harryxni/TopMetalSe-OpenMPW6/Photos/m5_small.jpg

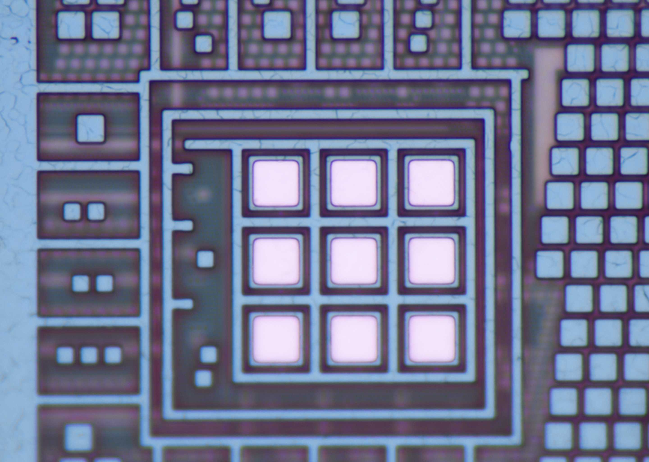
Photos/m5_small.jpg
