harryxni/TopMetalSe-OpenMPW6/Photos/tmse11.jpg

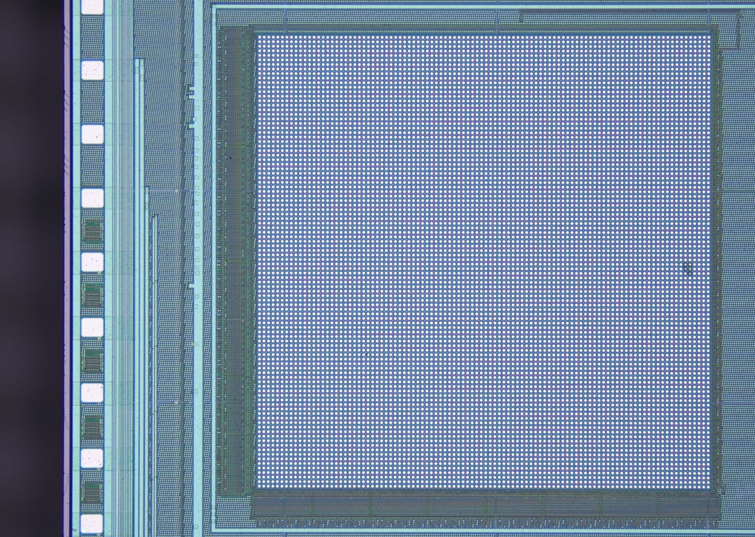
Photos/tmse11.jpg
