harryxni/TopMetalSe-OpenMPW6/Photos/tmse14.jpg

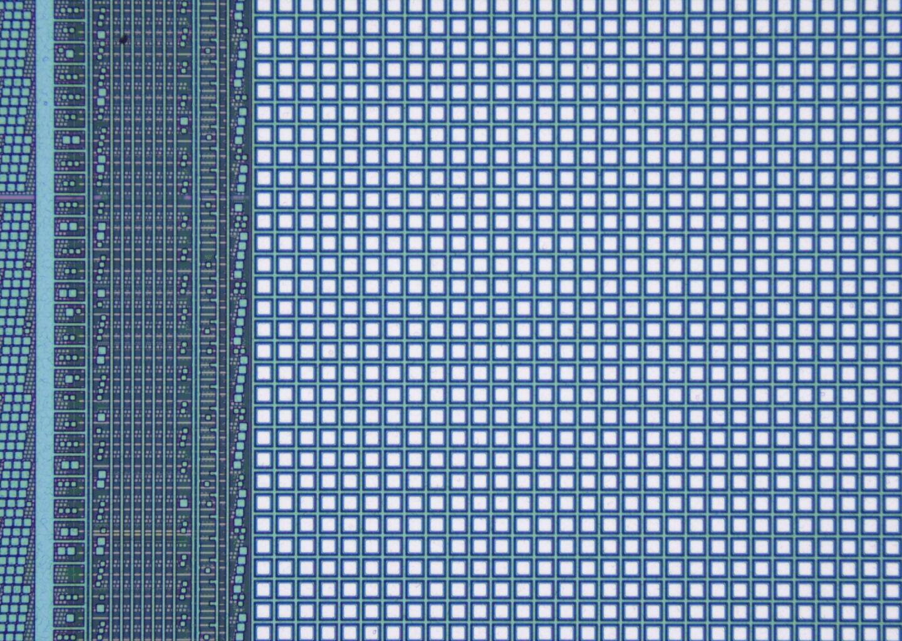
Photos/tmse14.jpg
