harryxni/TopMetalSe-OpenMPW6/Photos/tmse16.jpg

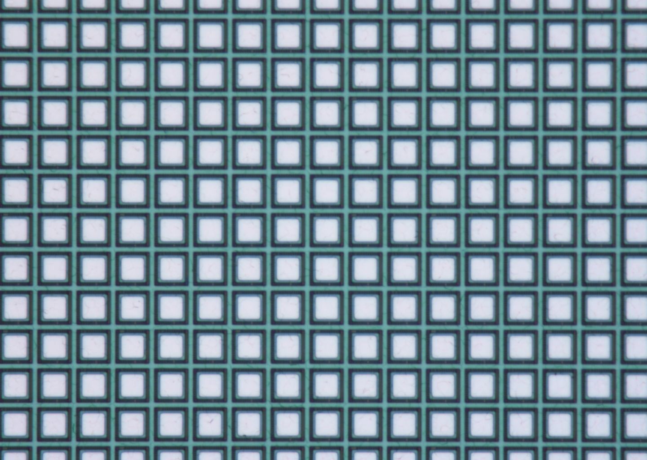
Photos/tmse16.jpg
