harryxni/TopMetalSe-OpenMPW6/Photos/tmse17.jpg

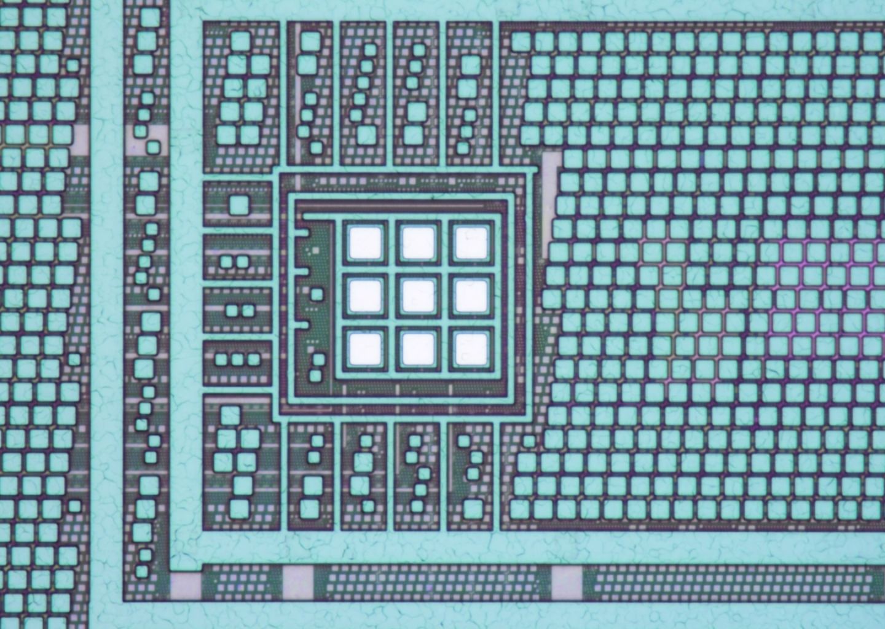
Photos/tmse17.jpg
