harryxni/TopMetalSe-OpenMPW6/Photos/tmse19.jpg

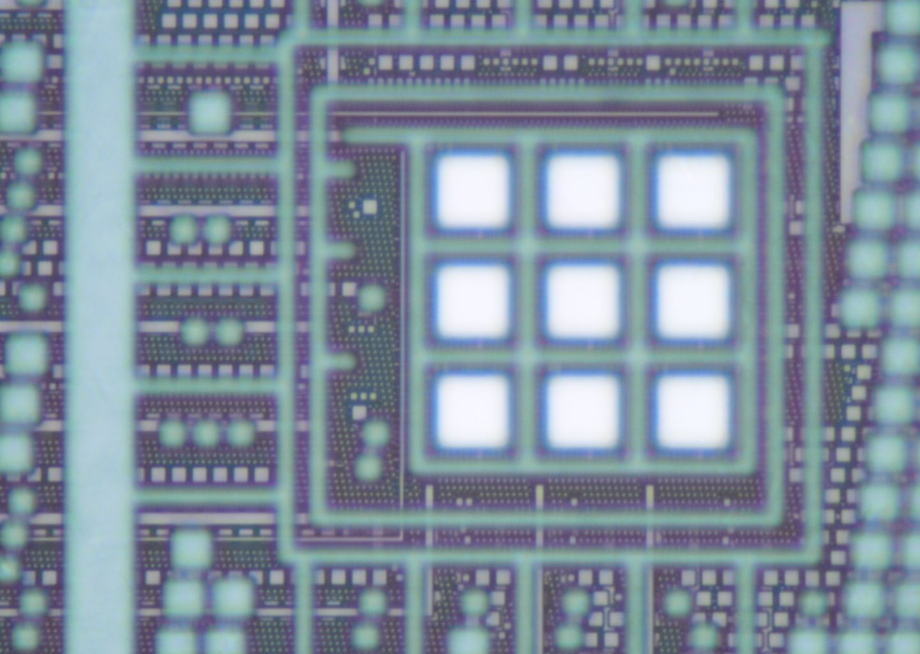
Photos/tmse19.jpg
