harryxni/TopMetalSe-OpenMPW6/Photos/tmse-dps00.jpg

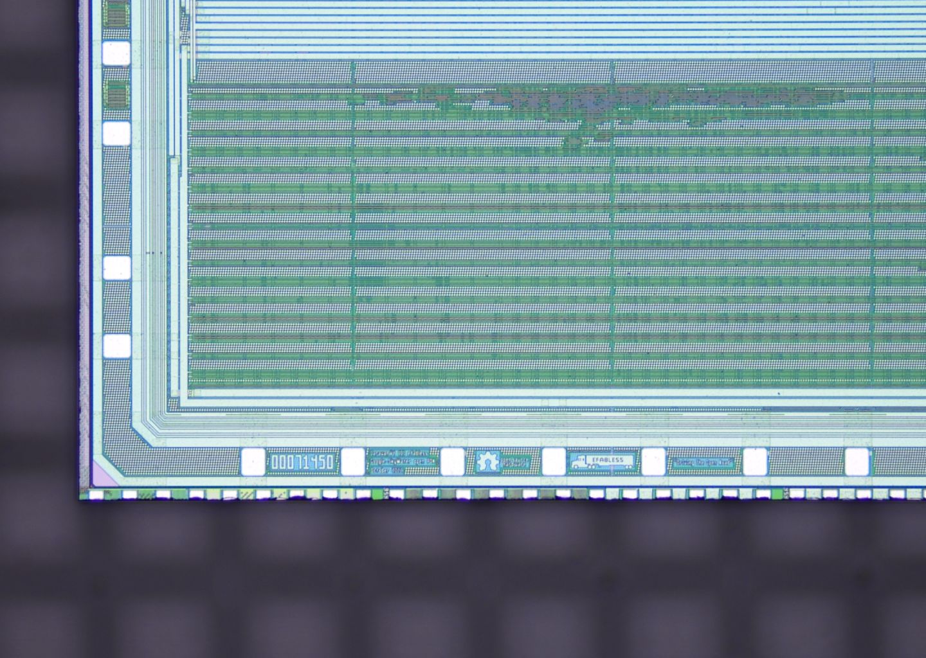
Photos/tmse-dps00.jpg
