harryxni/TopMetalSe-OpenMPW6/Photos/tmse-dps01.jpg

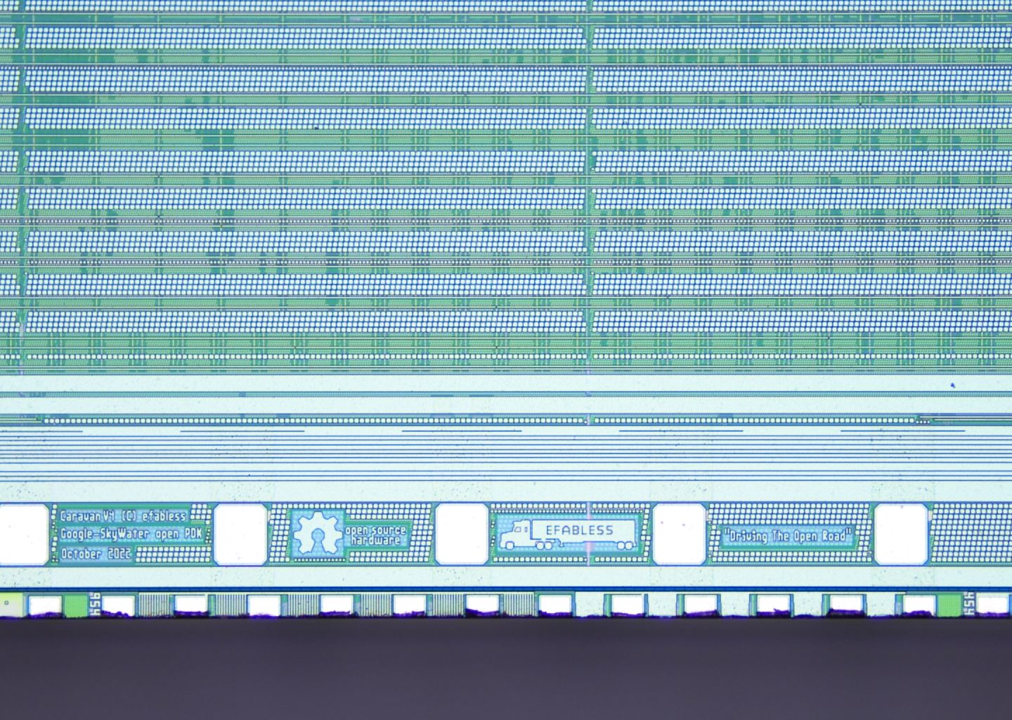
Photos/tmse-dps01.jpg
