harryxni/TopMetalSe-OpenMPW6/Photos/tmse-dps02.jpg

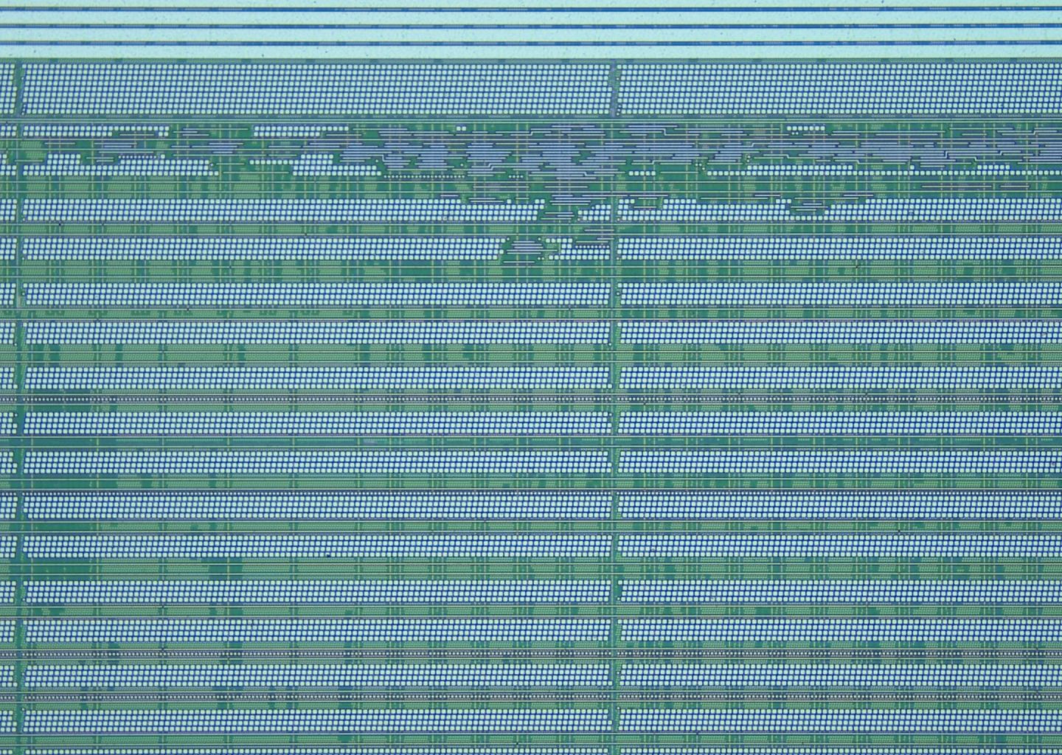
Photos/tmse-dps02.jpg
