harryxni/TopMetalSe-OpenMPW6/Photos/tmse-dps06.jpg

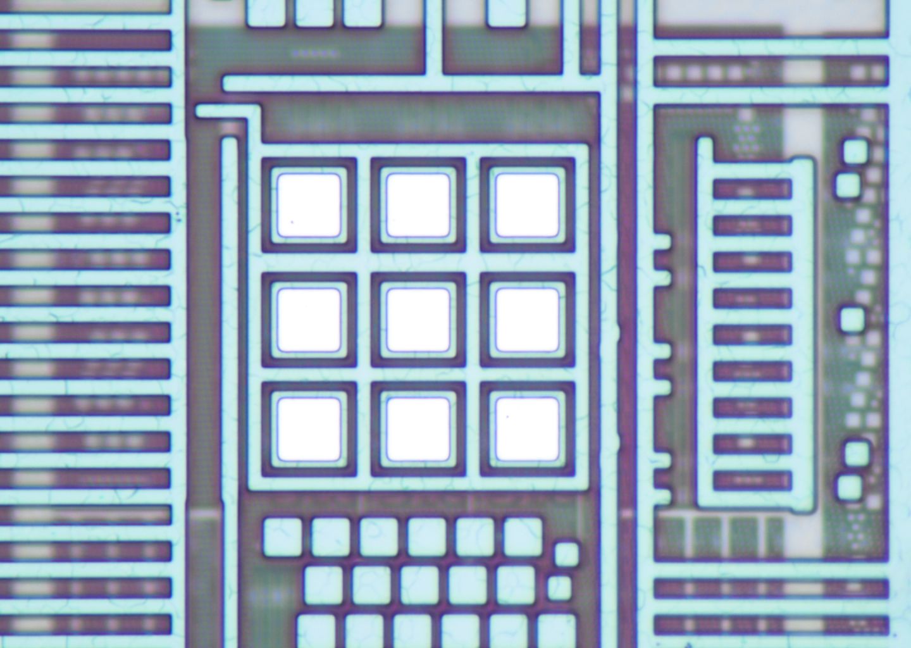
Photos/tmse-dps06.jpg
