harryxni/TopMetalSe-OpenMPW6/Photos/tmse-dps08.jpg

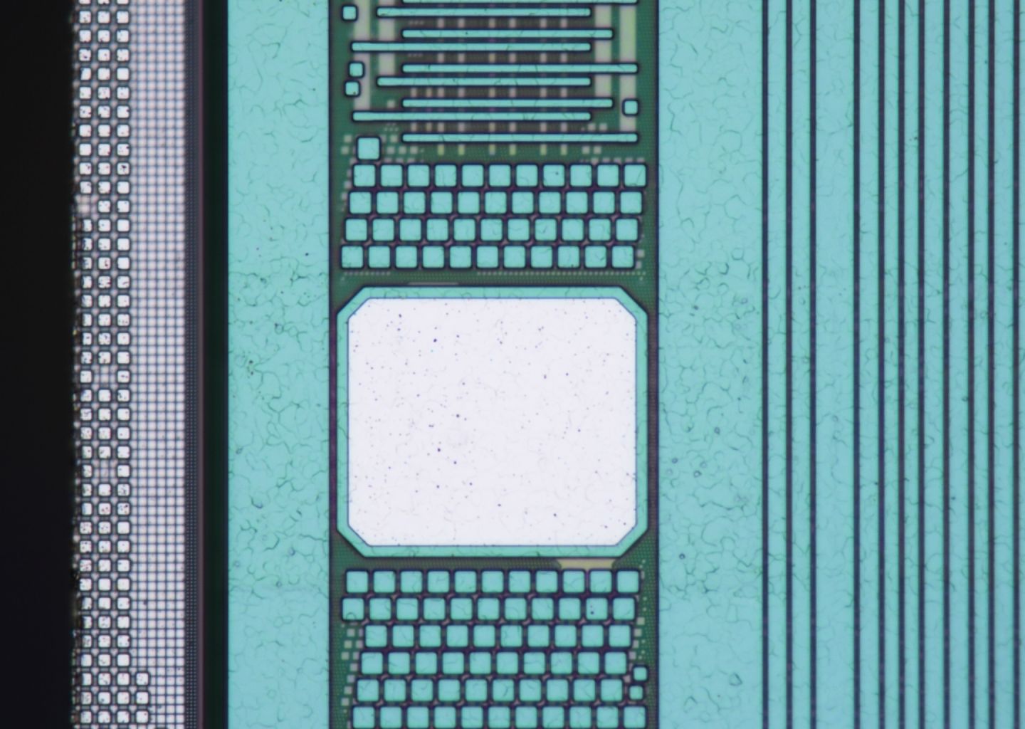
Photos/tmse-dps08.jpg
