harryxni/TopMetalSe-OpenMPW6/Photos/tmse-dps09.jpg

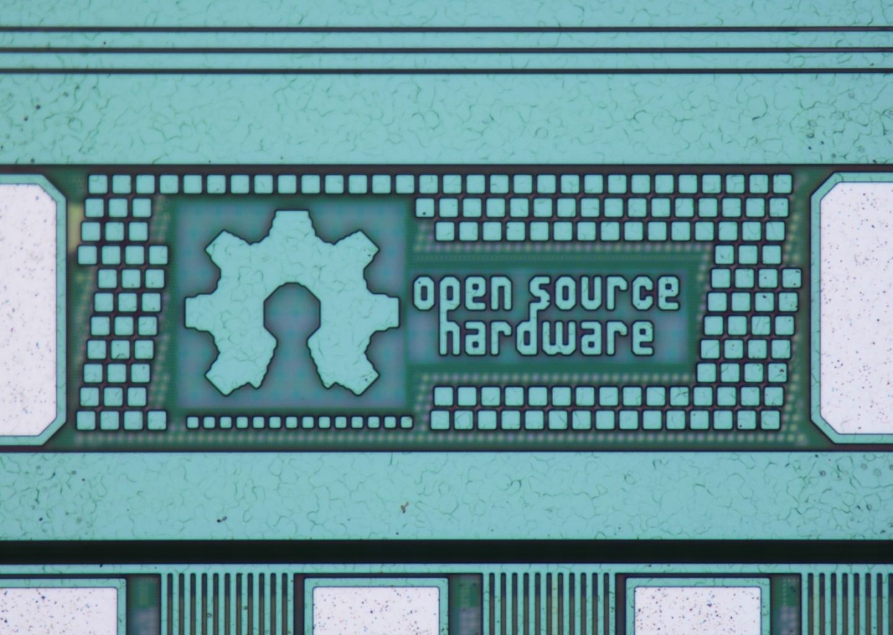
Photos/tmse-dps09.jpg
