harryxni/TopMetalSe-OpenMPW6/Photos/tmse-dps10.jpg

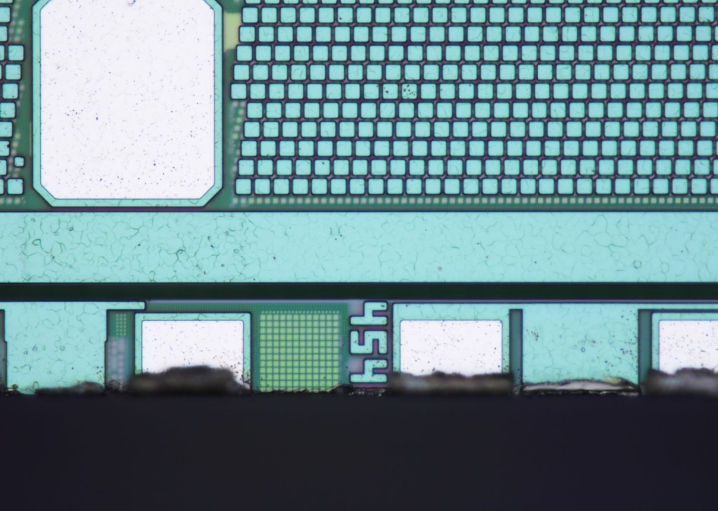
Photos/tmse-dps10.jpg
