harryxni/TopMetalSe-OpenMPW6/xschem/csa.pdf

# /home/damic/CMOS/TopmetalSe/Pixel/Schematic/csa.sch

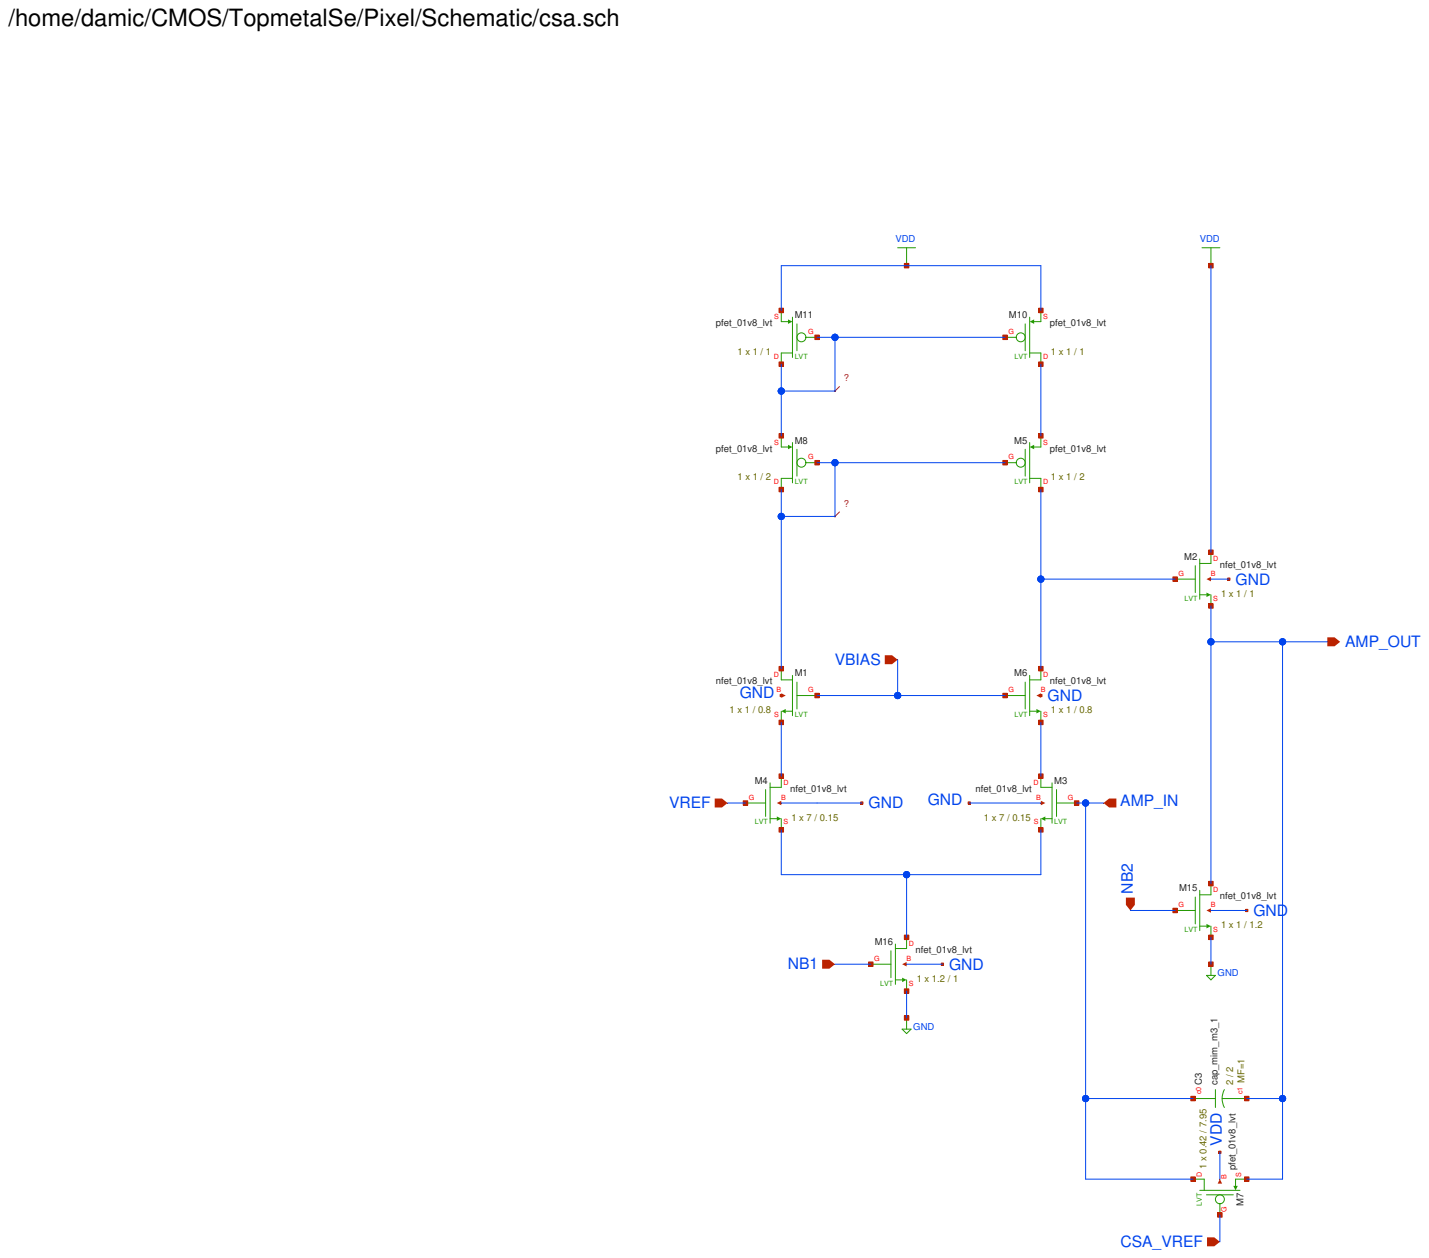
[picture p23: page 1]
VDD; GND; VREF; AMP_IN; CSA_VREF; VBIAS; AMP_OUT; nfet_01v8_lvt; 1 x 1 / 1 LVT; LVT; pfet_01v8_lvt; 1 x 1 / 1.2 LVT; 1 x 1.2 / 1 LVT; cap_mim_m3_1; 1 x 7 / 0.15 LVT; 1 x 1 / 0.8 LVT
