harryxni/TopMetalSe-OpenMPW6/xschem/pixel.pdf

# untitled.sch

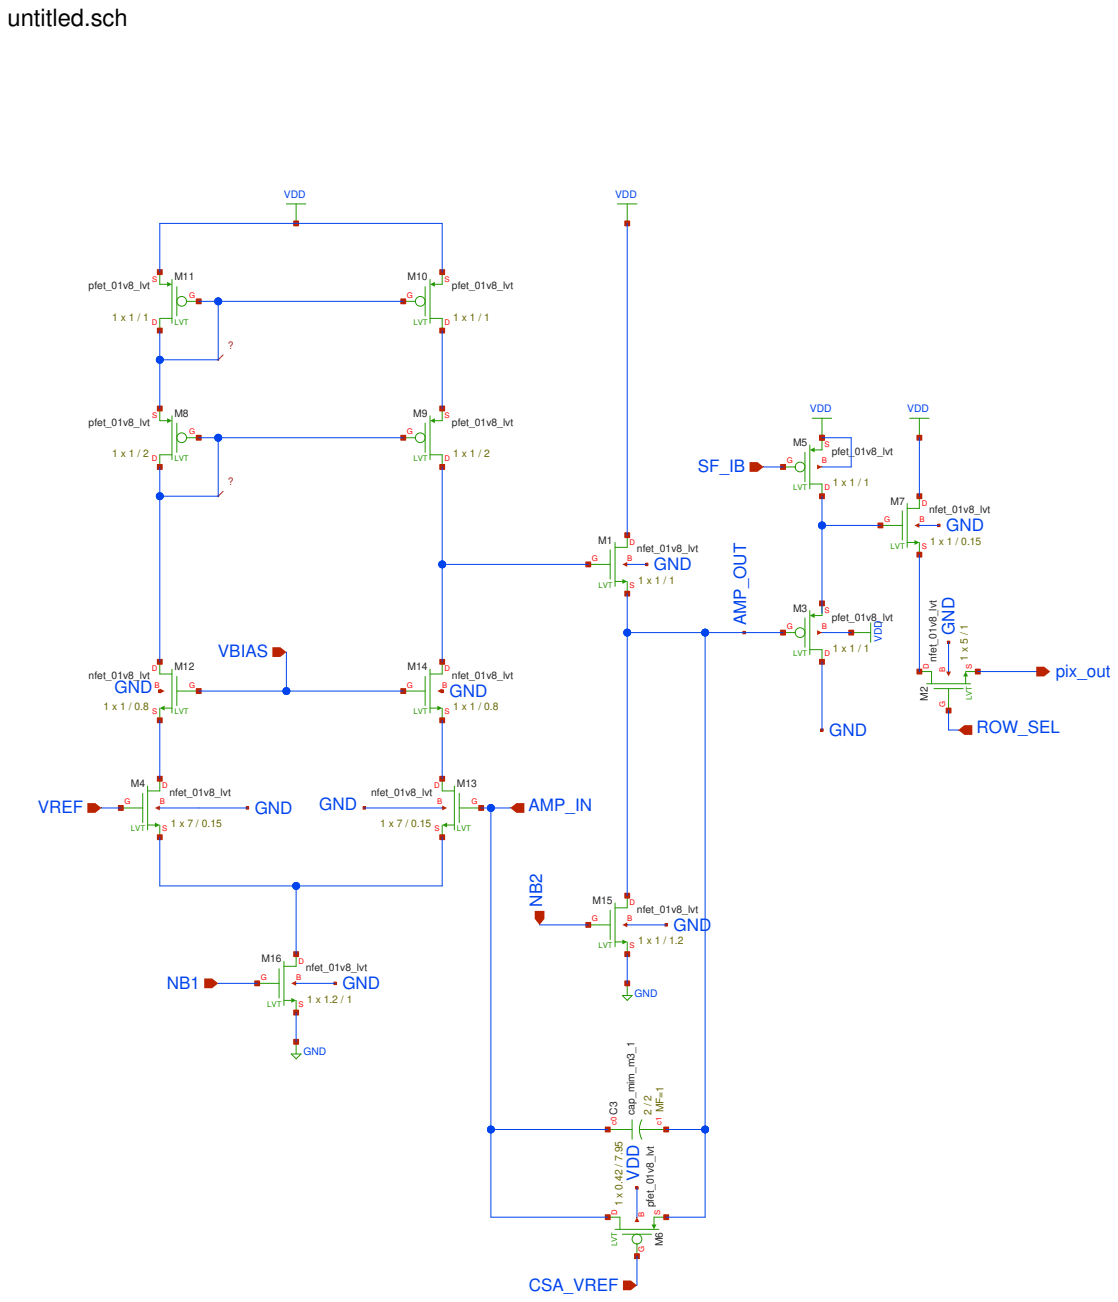
[picture p24: page 1]
AMP_OUT; GND; VDD; pix_out; ROW_SEL; VREF; AMP_IN; CSA_VREF; VBIAS; nfet_01v8_lvt; 1 x 5 / 1 LVT; LVT; pfet_01v8_lvt; 1 x 1 / 0.15 LVT M1; 1 x 1 / 1 LVT; 1 x 1 / 1.2 LVT; 1 x 1.2 / 1 LVT; cap_mim_m3_1; 1 x 7 / 0.15 LVT; 1 x 1 / 0.8 LVT
