harryxni/TopMetalSe-OpenMPW6/mag/test_structures/test_wrapper.spice

magic
tech sky130A
magscale 1 2
timestamp 1654709783
<< error_p >>
rect 452877 671886 452911 672462
rect 452995 671886 453029 672462
rect 453113 671886 453147 672462
rect 453231 671886 453265 672462
rect 453349 671886 453383 672462
rect 453467 671886 453501 672462
rect 453585 671886 453619 672462
rect 453703 671886 453737 672462
rect 453821 671886 453855 672462
rect 453939 671886 453973 672462
rect 454057 671886 454091 672462
rect 454175 671886 454209 672462
rect 454293 671886 454327 672462
rect 454411 671886 454445 672462
rect 454529 671886 454563 672462
rect 454647 671886 454681 672462
rect 454765 671886 454799 672462
rect 454883 671886 454917 672462
rect 455001 671886 455035 672462
rect 455119 671886 455153 672462
rect 455237 671886 455271 672462
rect 455355 671886 455389 672462
rect 455473 671886 455507 672462
rect 455591 671886 455625 672462
rect 457000 671886 457034 672462
rect 457118 671886 457152 672462
rect 457236 671886 457270 672462
rect 457354 671886 457388 672462
rect 457472 671886 457506 672462
rect 457590 671886 457624 672462
rect 457708 671886 457742 672462
rect 457826 671886 457860 672462
rect 457944 671886 457978 672462
rect 458062 671886 458096 672462
rect 458180 671886 458214 672462
rect 458298 671886 458332 672462
rect 458416 671886 458450 672462
rect 458534 671886 458568 672462
rect 458652 671886 458686 672462
rect 458770 671886 458804 672462
rect 458888 671886 458922 672462
rect 459006 671886 459040 672462
rect 459124 671886 459158 672462
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
rect 446485 663404 446519 663980
rect 446603 663404 446637 663980
rect 446721 663404 446755 663980
rect 446839 663404 446873 663980
rect 446957 663404 446991 663980
rect 447075 663404 447109 663980
rect 447193 663404 447227 663980
rect 447311 663404 447345 663980
rect 447429 663404 447463 663980
rect 447547 663404 447581 663980
rect 447665 663404 447699 663980
rect 447783 663404 447817 663980
rect 447901 663404 447935 663980
rect 448019 663404 448053 663980
rect 448137 663404 448171 663980
rect 448255 663404 448289 663980
rect 448373 663404 448407 663980
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
