harryxni/TopMetalSe-OpenMPW6/mag/test_structures/opamp_diego.spice

* NGSPICE file created from opamp_diego.ext - technology: sky130A

.subckt sky130_fd_pr__pfet_01v8_YT7TV5 a_n505_21# a_n387_21# a_384_118# w_n1642_n937#
+ a_n623_21# a_620_118# a_n387_n815# a_n1150_118# a_n33_n815# a_n741_21# a_321_n815#
+ a_n560_n718# a_675_n815# a_1092_n718# a_n1331_n815# a_n1449_21# a_n914_n718# a_1446_n718#
+ a_1029_n815# a_n151_21# a_n560_118# a_1092_118# a_n269_n815# a_620_n718# a_1328_118#
+ a_30_118# a_203_n815# a_974_n718# a_n442_n718# a_557_n815# a_n796_n718# a_439_21#
+ a_n1213_n815# a_n1213_21# a_n1095_21# a_557_21# a_1328_n718# a_n1331_21# a_n206_118#
+ a_675_21# a_738_118# a_911_21# a_n1268_118# a_793_21# a_n1504_118# a_502_n718# a_n1095_n815#
+ a_856_n718# a_85_n815# a_n324_n718# a_439_n815# a_203_21# a_n678_n718# a_148_118#
+ a_n1449_n815# a_321_21# a_n678_118# a_n33_21# a_n914_118# a_1446_118# a_384_n718#
+ a_1029_21# a_n741_n815# a_30_n718# a_1147_21# a_738_n718# a_n206_n718# a_n324_118#
+ a_1265_21# a_n1150_n718# a_856_118# a_1383_n815# a_1383_21# a_n1386_118# a_n1504_n718#
+ a_266_n718# a_n88_118# a_266_118# a_n623_n815# a_n977_n815# a_502_118# a_n796_118#
+ a_n88_n718# a_n1032_118# a_911_n815# a_n1032_n718# a_1265_n815# a_n1386_n718# a_n151_n815#
+ a_n859_21# a_148_n718# a_n442_118# a_974_118# a_n505_n815# a_n977_21# a_1210_118#
+ a_793_n815# a_n859_n815# a_85_21# a_1210_n718# a_n269_21# a_1147_n815# a_n1268_n718#
X0 a_1446_118# a_1383_21# a_1328_118# w_n1642_n937# sky130_fd_pr__pfet_01v8 ad=8.7e+11p pd=6.58e+06u as=8.7e+11p ps=6.58e+06u w=3e+06u l=300000u
X1 a_n1032_n718# a_n1095_n815# a_n1150_n718# w_n1642_n937# sky130_fd_pr__pfet_01v8 ad=8.7e+11p pd=6.58e+06u as=8.7e+11p ps=6.58e+06u w=3e+06u l=300000u
X2 a_n796_118# a_n859_21# a_n914_118# w_n1642_n937# sky130_fd_pr__pfet_01v8 ad=8.7e+11p pd=6.58e+06u as=8.7e+11p ps=6.58e+06u w=3e+06u l=300000u
X3 a_384_118# a_321_21# a_266_118# w_n1642_n937# sky130_fd_pr__pfet_01v8 ad=8.7e+11p pd=6.58e+06u as=8.7e+11p ps=6.58e+06u w=3e+06u l=300000u
X4 a_384_n718# a_321_n815# a_266_n718# w_n1642_n937# sky130_fd_pr__pfet_01v8 ad=8.7e+11p pd=6.58e+06u as=8.7e+11p ps=6.58e+06u w=3e+06u l=300000u
X5 a_n88_n718# a_n151_n815# a_n206_n718# w_n1642_n937# sky130_fd_pr__pfet_01v8 ad=8.7e+11p pd=6.58e+06u as=8.7e+11p ps=6.58e+06u w=3e+06u l=300000u
X6 a_1328_118# a_1265_21# a_1210_118# w_n1642_n937# sky130_fd_pr__pfet_01v8 ad=0p pd=0u as=8.7e+11p ps=6.58e+06u w=3e+06u l=300000u
X7 a_n1150_n718# a_n1213_n815# a_n1268_n718# w_n1642_n937# sky130_fd_pr__pfet_01v8 ad=0p pd=0u as=8.7e+11p ps=6.58e+06u w=3e+06u l=300000u
X8 a_n678_118# a_n741_21# a_n796_118# w_n1642_n937# sky130_fd_pr__pfet_01v8 ad=8.7e+11p pd=6.58e+06u as=0p ps=0u w=3e+06u l=300000u
X9 a_1210_n718# a_1147_n815# a_1092_n718# w_n1642_n937# sky130_fd_pr__pfet_01v8 ad=8.7e+11p pd=6.58e+06u as=8.7e+11p ps=6.58e+06u w=3e+06u l=300000u
X10 a_266_118# a_203_21# a_148_118# w_n1642_n937# sky130_fd_pr__pfet_01v8 ad=0p pd=0u as=8.7e+11p ps=6.58e+06u w=3e+06u l=300000u
X11 a_30_n718# a_n33_n815# a_n88_n718# w_n1642_n937# sky130_fd_pr__pfet_01v8 ad=8.7e+11p pd=6.58e+06u as=0p ps=0u w=3e+06u l=300000u
X12 a_1210_118# a_1147_21# a_1092_118# w_n1642_n937# sky130_fd_pr__pfet_01v8 ad=0p pd=0u as=8.7e+11p ps=6.58e+06u w=3e+06u l=300000u
X13 a_n914_n718# a_n977_n815# a_n1032_n718# w_n1642_n937# sky130_fd_pr__pfet_01v8 ad=8.7e+11p pd=6.58e+06u as=0p ps=0u w=3e+06u l=300000u
X14 a_n560_n718# a_n623_n815# a_n678_n718# w_n1642_n937# sky130_fd_pr__pfet_01v8 ad=8.7e+11p pd=6.58e+06u as=8.7e+11p ps=6.58e+06u w=3e+06u l=300000u
X15 a_1446_n718# a_1383_n815# a_1328_n718# w_n1642_n937# sky130_fd_pr__pfet_01v8 ad=8.7e+11p pd=6.58e+06u as=8.7e+11p ps=6.58e+06u w=3e+06u l=300000u
X16 a_n560_118# a_n623_21# a_n678_118# w_n1642_n937# sky130_fd_pr__pfet_01v8 ad=8.7e+11p pd=6.58e+06u as=0p ps=0u w=3e+06u l=300000u
X17 a_266_n718# a_203_n815# a_148_n718# w_n1642_n937# sky130_fd_pr__pfet_01v8 ad=0p pd=0u as=8.7e+11p ps=6.58e+06u w=3e+06u l=300000u
X18 a_620_n718# a_557_n815# a_502_n718# w_n1642_n937# sky130_fd_pr__pfet_01v8 ad=8.7e+11p pd=6.58e+06u as=8.7e+11p ps=6.58e+06u w=3e+06u l=300000u
X19 a_n1386_118# a_n1449_21# a_n1504_118# w_n1642_n937# sky130_fd_pr__pfet_01v8 ad=8.7e+11p pd=6.58e+06u as=8.7e+11p ps=6.58e+06u w=3e+06u l=300000u
X20 a_n324_118# a_n387_21# a_n442_118# w_n1642_n937# sky130_fd_pr__pfet_01v8 ad=8.7e+11p pd=6.58e+06u as=8.7e+11p ps=6.58e+06u w=3e+06u l=300000u
X21 a_856_118# a_793_21# a_738_118# w_n1642_n937# sky130_fd_pr__pfet_01v8 ad=8.7e+11p pd=6.58e+06u as=8.7e+11p ps=6.58e+06u w=3e+06u l=300000u
X22 a_1092_118# a_1029_21# a_974_118# w_n1642_n937# sky130_fd_pr__pfet_01v8 ad=0p pd=0u as=8.7e+11p ps=6.58e+06u w=3e+06u l=300000u
X23 a_n324_n718# a_n387_n815# a_n442_n718# w_n1642_n937# sky130_fd_pr__pfet_01v8 ad=8.7e+11p pd=6.58e+06u as=8.7e+11p ps=6.58e+06u w=3e+06u l=300000u
X24 a_n442_118# a_n505_21# a_n560_118# w_n1642_n937# sky130_fd_pr__pfet_01v8 ad=0p pd=0u as=0p ps=0u w=3e+06u l=300000u
X25 a_148_118# a_85_21# a_30_118# w_n1642_n937# sky130_fd_pr__pfet_01v8 ad=0p pd=0u as=8.7e+11p ps=6.58e+06u w=3e+06u l=300000u
X26 a_n1386_n718# a_n1449_n815# a_n1504_n718# w_n1642_n937# sky130_fd_pr__pfet_01v8 ad=8.7e+11p pd=6.58e+06u as=8.7e+11p ps=6.58e+06u w=3e+06u l=300000u
X27 a_856_n718# a_793_n815# a_738_n718# w_n1642_n937# sky130_fd_pr__pfet_01v8 ad=8.7e+11p pd=6.58e+06u as=8.7e+11p ps=6.58e+06u w=3e+06u l=300000u
X28 a_974_118# a_911_21# a_856_118# w_n1642_n937# sky130_fd_pr__pfet_01v8 ad=0p pd=0u as=0p ps=0u w=3e+06u l=300000u
X29 a_1092_n718# a_1029_n815# a_974_n718# w_n1642_n937# sky130_fd_pr__pfet_01v8 ad=0p pd=0u as=8.7e+11p ps=6.58e+06u w=3e+06u l=300000u
X30 a_n1268_118# a_n1331_21# a_n1386_118# w_n1642_n937# sky130_fd_pr__pfet_01v8 ad=8.7e+11p pd=6.58e+06u as=0p ps=0u w=3e+06u l=300000u
X31 a_n206_118# a_n269_21# a_n324_118# w_n1642_n937# sky130_fd_pr__pfet_01v8 ad=8.7e+11p pd=6.58e+06u as=0p ps=0u w=3e+06u l=300000u
X32 a_738_118# a_675_21# a_620_118# w_n1642_n937# sky130_fd_pr__pfet_01v8 ad=0p pd=0u as=8.7e+11p ps=6.58e+06u w=3e+06u l=300000u
X33 a_n796_n718# a_n859_n815# a_n914_n718# w_n1642_n937# sky130_fd_pr__pfet_01v8 ad=8.7e+11p pd=6.58e+06u as=0p ps=0u w=3e+06u l=300000u
X34 a_n1032_118# a_n1095_21# a_n1150_118# w_n1642_n937# sky130_fd_pr__pfet_01v8 ad=8.7e+11p pd=6.58e+06u as=8.7e+11p ps=6.58e+06u w=3e+06u l=300000u
X35 a_148_n718# a_85_n815# a_30_n718# w_n1642_n937# sky130_fd_pr__pfet_01v8 ad=0p pd=0u as=0p ps=0u w=3e+06u l=300000u
X36 a_1328_n718# a_1265_n815# a_1210_n718# w_n1642_n937# sky130_fd_pr__pfet_01v8 ad=0p pd=0u as=0p ps=0u w=3e+06u l=300000u
X37 a_n88_118# a_n151_21# a_n206_118# w_n1642_n937# sky130_fd_pr__pfet_01v8 ad=8.7e+11p pd=6.58e+06u as=0p ps=0u w=3e+06u l=300000u
X38 a_30_118# a_n33_21# a_n88_118# w_n1642_n937# sky130_fd_pr__pfet_01v8 ad=0p pd=0u as=0p ps=0u w=3e+06u l=300000u
X39 a_620_118# a_557_21# a_502_118# w_n1642_n937# sky130_fd_pr__pfet_01v8 ad=0p pd=0u as=8.7e+11p ps=6.58e+06u w=3e+06u l=300000u
X40 a_502_n718# a_439_n815# a_384_n718# w_n1642_n937# sky130_fd_pr__pfet_01v8 ad=0p pd=0u as=0p ps=0u w=3e+06u l=300000u
X41 a_n1150_118# a_n1213_21# a_n1268_118# w_n1642_n937# sky130_fd_pr__pfet_01v8 ad=0p pd=0u as=0p ps=0u w=3e+06u l=300000u
X42 a_n206_n718# a_n269_n815# a_n324_n718# w_n1642_n937# sky130_fd_pr__pfet_01v8 ad=0p pd=0u as=0p ps=0u w=3e+06u l=300000u
X43 a_738_n718# a_675_n815# a_620_n718# w_n1642_n937# sky130_fd_pr__pfet_01v8 ad=0p pd=0u as=0p ps=0u w=3e+06u l=300000u
X44 a_n1268_n718# a_n1331_n815# a_n1386_n718# w_n1642_n937# sky130_fd_pr__pfet_01v8 ad=0p pd=0u as=0p ps=0u w=3e+06u l=300000u
X45 a_n914_118# a_n977_21# a_n1032_118# w_n1642_n937# sky130_fd_pr__pfet_01v8 ad=0p pd=0u as=0p ps=0u w=3e+06u l=300000u
X46 a_n442_n718# a_n505_n815# a_n560_n718# w_n1642_n937# sky130_fd_pr__pfet_01v8 ad=0p pd=0u as=0p ps=0u w=3e+06u l=300000u
X47 a_502_118# a_439_21# a_384_118# w_n1642_n937# sky130_fd_pr__pfet_01v8 ad=0p pd=0u as=0p ps=0u w=3e+06u l=300000u
X48 a_974_n718# a_911_n815# a_856_n718# w_n1642_n937# sky130_fd_pr__pfet_01v8 ad=0p pd=0u as=0p ps=0u w=3e+06u l=300000u
X49 a_n678_n718# a_n741_n815# a_n796_n718# w_n1642_n937# sky130_fd_pr__pfet_01v8 ad=0p pd=0u as=0p ps=0u w=3e+06u l=300000u
.ends

.subckt sky130_fd_pr__nfet_01v8_8HUREQ a_384_n709# a_557_n797# a_203_n797# a_n387_21#
+ a_n505_21# a_30_n709# a_n623_21# a_738_n709# a_n206_n709# a_n741_21# a_n324_109#
+ a_856_109# a_85_n797# a_n151_21# a_266_n709# a_439_n797# a_n88_109# a_266_109# a_n88_n709#
+ a_502_109# a_n796_109# a_439_21# w_n1052_n919# a_n741_n797# a_557_21# a_148_n709#
+ a_675_21# a_n442_109# a_793_21# a_203_21# a_n623_n797# a_321_21# a_620_109# a_384_109#
+ a_n33_21# a_n560_n709# a_n151_n797# a_n914_n709# a_793_n797# a_n505_n797# a_n859_n797#
+ a_n560_109# a_620_n709# a_n442_n709# a_30_109# a_n796_n709# a_n387_n797# a_321_n797#
+ a_n33_n797# a_n206_109# a_675_n797# a_738_109# a_502_n709# a_n859_21# a_856_n709#
+ a_n324_n709# a_n678_n709# a_148_109# a_85_21# a_n269_n797# a_n678_109# a_n914_109#
+ a_n269_21#
X0 a_n678_109# a_n741_21# a_n796_109# w_n1052_n919# sky130_fd_pr__nfet_01v8 ad=8.7e+11p pd=6.58e+06u as=8.7e+11p ps=6.58e+06u w=3e+06u l=300000u
X1 a_266_109# a_203_21# a_148_109# w_n1052_n919# sky130_fd_pr__nfet_01v8 ad=8.7e+11p pd=6.58e+06u as=8.7e+11p ps=6.58e+06u w=3e+06u l=300000u
X2 a_30_n709# a_n33_n797# a_n88_n709# w_n1052_n919# sky130_fd_pr__nfet_01v8 ad=8.7e+11p pd=6.58e+06u as=8.7e+11p ps=6.58e+06u w=3e+06u l=300000u
X3 a_n560_n709# a_n623_n797# a_n678_n709# w_n1052_n919# sky130_fd_pr__nfet_01v8 ad=8.7e+11p pd=6.58e+06u as=8.7e+11p ps=6.58e+06u w=3e+06u l=300000u
X4 a_n560_109# a_n623_21# a_n678_109# w_n1052_n919# sky130_fd_pr__nfet_01v8 ad=8.7e+11p pd=6.58e+06u as=0p ps=0u w=3e+06u l=300000u
X5 a_n324_109# a_n387_21# a_n442_109# w_n1052_n919# sky130_fd_pr__nfet_01v8 ad=8.7e+11p pd=6.58e+06u as=8.7e+11p ps=6.58e+06u w=3e+06u l=300000u
X6 a_266_n709# a_203_n797# a_148_n709# w_n1052_n919# sky130_fd_pr__nfet_01v8 ad=8.7e+11p pd=6.58e+06u as=8.7e+11p ps=6.58e+06u w=3e+06u l=300000u
X7 a_620_n709# a_557_n797# a_502_n709# w_n1052_n919# sky130_fd_pr__nfet_01v8 ad=8.7e+11p pd=6.58e+06u as=8.7e+11p ps=6.58e+06u w=3e+06u l=300000u
X8 a_856_109# a_793_21# a_738_109# w_n1052_n919# sky130_fd_pr__nfet_01v8 ad=8.7e+11p pd=6.58e+06u as=8.7e+11p ps=6.58e+06u w=3e+06u l=300000u
X9 a_n324_n709# a_n387_n797# a_n442_n709# w_n1052_n919# sky130_fd_pr__nfet_01v8 ad=8.7e+11p pd=6.58e+06u as=8.7e+11p ps=6.58e+06u w=3e+06u l=300000u
X10 a_n442_109# a_n505_21# a_n560_109# w_n1052_n919# sky130_fd_pr__nfet_01v8 ad=0p pd=0u as=0p ps=0u w=3e+06u l=300000u
X11 a_148_109# a_85_21# a_30_109# w_n1052_n919# sky130_fd_pr__nfet_01v8 ad=0p pd=0u as=8.7e+11p ps=6.58e+06u w=3e+06u l=300000u
X12 a_856_n709# a_793_n797# a_738_n709# w_n1052_n919# sky130_fd_pr__nfet_01v8 ad=8.7e+11p pd=6.58e+06u as=8.7e+11p ps=6.58e+06u w=3e+06u l=300000u
X13 a_n206_109# a_n269_21# a_n324_109# w_n1052_n919# sky130_fd_pr__nfet_01v8 ad=8.7e+11p pd=6.58e+06u as=0p ps=0u w=3e+06u l=300000u
X14 a_738_109# a_675_21# a_620_109# w_n1052_n919# sky130_fd_pr__nfet_01v8 ad=0p pd=0u as=8.7e+11p ps=6.58e+06u w=3e+06u l=300000u
X15 a_n796_n709# a_n859_n797# a_n914_n709# w_n1052_n919# sky130_fd_pr__nfet_01v8 ad=8.7e+11p pd=6.58e+06u as=8.7e+11p ps=6.58e+06u w=3e+06u l=300000u
X16 a_148_n709# a_85_n797# a_30_n709# w_n1052_n919# sky130_fd_pr__nfet_01v8 ad=0p pd=0u as=0p ps=0u w=3e+06u l=300000u
X17 a_620_109# a_557_21# a_502_109# w_n1052_n919# sky130_fd_pr__nfet_01v8 ad=0p pd=0u as=8.7e+11p ps=6.58e+06u w=3e+06u l=300000u
X18 a_n88_109# a_n151_21# a_n206_109# w_n1052_n919# sky130_fd_pr__nfet_01v8 ad=8.7e+11p pd=6.58e+06u as=0p ps=0u w=3e+06u l=300000u
X19 a_30_109# a_n33_21# a_n88_109# w_n1052_n919# sky130_fd_pr__nfet_01v8 ad=0p pd=0u as=0p ps=0u w=3e+06u l=300000u
X20 a_502_n709# a_439_n797# a_384_n709# w_n1052_n919# sky130_fd_pr__nfet_01v8 ad=0p pd=0u as=8.7e+11p ps=6.58e+06u w=3e+06u l=300000u
X21 a_n206_n709# a_n269_n797# a_n324_n709# w_n1052_n919# sky130_fd_pr__nfet_01v8 ad=8.7e+11p pd=6.58e+06u as=0p ps=0u w=3e+06u l=300000u
X22 a_738_n709# a_675_n797# a_620_n709# w_n1052_n919# sky130_fd_pr__nfet_01v8 ad=0p pd=0u as=0p ps=0u w=3e+06u l=300000u
X23 a_n442_n709# a_n505_n797# a_n560_n709# w_n1052_n919# sky130_fd_pr__nfet_01v8 ad=0p pd=0u as=0p ps=0u w=3e+06u l=300000u
X24 a_502_109# a_439_21# a_384_109# w_n1052_n919# sky130_fd_pr__nfet_01v8 ad=0p pd=0u as=8.7e+11p ps=6.58e+06u w=3e+06u l=300000u
X25 a_n678_n709# a_n741_n797# a_n796_n709# w_n1052_n919# sky130_fd_pr__nfet_01v8 ad=0p pd=0u as=0p ps=0u w=3e+06u l=300000u
X26 a_n796_109# a_n859_21# a_n914_109# w_n1052_n919# sky130_fd_pr__nfet_01v8 ad=0p pd=0u as=8.7e+11p ps=6.58e+06u w=3e+06u l=300000u
X27 a_384_109# a_321_21# a_266_109# w_n1052_n919# sky130_fd_pr__nfet_01v8 ad=0p pd=0u as=0p ps=0u w=3e+06u l=300000u
X28 a_384_n709# a_321_n797# a_266_n709# w_n1052_n919# sky130_fd_pr__nfet_01v8 ad=0p pd=0u as=0p ps=0u w=3e+06u l=300000u
X29 a_n88_n709# a_n151_n797# a_n206_n709# w_n1052_n919# sky130_fd_pr__nfet_01v8 ad=0p pd=0u as=0p ps=0u w=3e+06u l=300000u
.ends

.subckt sky130_fd_pr__cap_mim_m3_1_BLS9H9 m3_n1941_n1600# c1_n1841_n1500#
X0 c1_n1841_n1500# m3_n1941_n1600# sky130_fd_pr__cap_mim_m3_1 l=1.5e+07u w=1.755e+07u
.ends

.subckt sky130_fd_pr__pfet_01v8_YC9MKB a_856_n300# a_n324_n300# a_n505_n397# a_n678_n300#
+ a_793_n397# a_n859_n397# a_384_n300# a_n387_n397# a_30_n300# a_321_n397# a_n33_n397#
+ a_738_n300# a_n206_n300# a_675_n397# a_266_n300# a_n269_n397# a_n88_n300# a_203_n397#
+ a_557_n397# a_148_n300# a_439_n397# a_85_n397# w_n1052_n519# a_n560_n300# a_n741_n397#
+ a_n914_n300# a_620_n300# a_n442_n300# a_n796_n300# a_n623_n397# a_n151_n397# a_502_n300#
X0 a_n560_n300# a_n623_n397# a_n678_n300# w_n1052_n519# sky130_fd_pr__pfet_01v8 ad=8.7e+11p pd=6.58e+06u as=8.7e+11p ps=6.58e+06u w=3e+06u l=300000u
X1 a_30_n300# a_n33_n397# a_n88_n300# w_n1052_n519# sky130_fd_pr__pfet_01v8 ad=8.7e+11p pd=6.58e+06u as=8.7e+11p ps=6.58e+06u w=3e+06u l=300000u
X2 a_266_n300# a_203_n397# a_148_n300# w_n1052_n519# sky130_fd_pr__pfet_01v8 ad=8.7e+11p pd=6.58e+06u as=8.7e+11p ps=6.58e+06u w=3e+06u l=300000u
X3 a_620_n300# a_557_n397# a_502_n300# w_n1052_n519# sky130_fd_pr__pfet_01v8 ad=8.7e+11p pd=6.58e+06u as=8.7e+11p ps=6.58e+06u w=3e+06u l=300000u
X4 a_n324_n300# a_n387_n397# a_n442_n300# w_n1052_n519# sky130_fd_pr__pfet_01v8 ad=8.7e+11p pd=6.58e+06u as=8.7e+11p ps=6.58e+06u w=3e+06u l=300000u
X5 a_856_n300# a_793_n397# a_738_n300# w_n1052_n519# sky130_fd_pr__pfet_01v8 ad=8.7e+11p pd=6.58e+06u as=8.7e+11p ps=6.58e+06u w=3e+06u l=300000u
X6 a_n796_n300# a_n859_n397# a_n914_n300# w_n1052_n519# sky130_fd_pr__pfet_01v8 ad=8.7e+11p pd=6.58e+06u as=8.7e+11p ps=6.58e+06u w=3e+06u l=300000u
X7 a_148_n300# a_85_n397# a_30_n300# w_n1052_n519# sky130_fd_pr__pfet_01v8 ad=0p pd=0u as=0p ps=0u w=3e+06u l=300000u
X8 a_502_n300# a_439_n397# a_384_n300# w_n1052_n519# sky130_fd_pr__pfet_01v8 ad=0p pd=0u as=8.7e+11p ps=6.58e+06u w=3e+06u l=300000u
X9 a_n206_n300# a_n269_n397# a_n324_n300# w_n1052_n519# sky130_fd_pr__pfet_01v8 ad=8.7e+11p pd=6.58e+06u as=0p ps=0u w=3e+06u l=300000u
X10 a_738_n300# a_675_n397# a_620_n300# w_n1052_n519# sky130_fd_pr__pfet_01v8 ad=0p pd=0u as=0p ps=0u w=3e+06u l=300000u
X11 a_n442_n300# a_n505_n397# a_n560_n300# w_n1052_n519# sky130_fd_pr__pfet_01v8 ad=0p pd=0u as=0p ps=0u w=3e+06u l=300000u
X12 a_n678_n300# a_n741_n397# a_n796_n300# w_n1052_n519# sky130_fd_pr__pfet_01v8 ad=0p pd=0u as=0p ps=0u w=3e+06u l=300000u
X13 a_384_n300# a_321_n397# a_266_n300# w_n1052_n519# sky130_fd_pr__pfet_01v8 ad=0p pd=0u as=0p ps=0u w=3e+06u l=300000u
X14 a_n88_n300# a_n151_n397# a_n206_n300# w_n1052_n519# sky130_fd_pr__pfet_01v8 ad=0p pd=0u as=0p ps=0u w=3e+06u l=300000u
.ends

.subckt sky130_fd_pr__nfet_01v8_GQFJAV a_15_n75# a_n69_97# a_n73_n75# w_n211_n285#
X0 a_15_n75# a_n69_97# a_n73_n75# w_n211_n285# sky130_fd_pr__nfet_01v8 ad=2.175e+11p pd=2.08e+06u as=2.175e+11p ps=2.08e+06u w=750000u l=150000u
.ends
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
