harryxni/TopMetalSe-OpenMPW6/mag/fulgor_opamp/opamp_v1.spice

* NGSPICE file created from opamp_v1.ext - technology: sky130A

.subckt sky130_fd_pr__pfet_01v8_YT7TV5 a_n1268_n718# a_1147_n815# VSUBS a_n269_21#
+ a_1210_n718# a_85_21# a_n859_n815# a_793_n815# a_1210_118# a_n977_21# a_n505_n815#
+ a_974_118# a_n442_118# a_148_n718# a_n859_21# a_n151_n815# a_n1386_n718# a_1265_n815#
+ a_n1032_n718# a_911_n815# a_n1032_118# a_n88_n718# a_n796_118# a_502_118# a_n977_n815#
+ a_n623_n815# a_266_118# a_n88_118# a_266_n718# a_n1504_n718# a_n1386_118# a_1383_21#
+ a_1383_n815# a_856_118# a_n1150_n718# a_1265_21# a_n324_118# a_n206_n718# a_738_n718#
+ a_1147_21# a_30_n718# a_n741_n815# a_1029_21# a_384_n718# a_1446_118# a_n914_118#
+ a_n33_21# a_n678_118# a_321_21# a_n1449_n815# a_148_118# a_n678_n718# a_203_21#
+ a_439_n815# a_n324_n718# a_85_n815# a_856_n718# a_n1095_n815# a_502_n718# a_n1504_118#
+ a_793_21# a_n1268_118# a_911_21# a_738_118# a_675_21# a_n206_118# a_n1331_21# a_1328_n718#
+ a_557_21# a_n1095_21# a_n1213_21# a_n1213_n815# a_439_21# a_n796_n718# a_557_n815#
+ a_n442_n718# a_974_n718# a_203_n815# a_30_118# a_1328_118# a_620_n718# a_n269_n815#
+ a_1092_118# a_n560_118# a_n151_21# a_1029_n815# a_1446_n718# a_n914_n718# a_n1449_21#
+ a_n1331_n815# a_1092_n718# a_675_n815# a_n560_n718# a_321_n815# a_n741_21# a_n33_n815#
+ a_n1150_118# a_n387_n815# a_620_118# a_n623_21# w_n1642_n937# a_384_118# a_n387_21#
+ a_n505_21#
X0 a_n796_118# a_n859_21# a_n914_118# w_n1642_n937# sky130_fd_pr__pfet_01v8 w=3e+06u l=300000u
X1 a_266_118# a_203_21# a_148_118# w_n1642_n937# sky130_fd_pr__pfet_01v8 w=3e+06u l=300000u
X2 a_1092_118# a_1029_21# a_974_118# w_n1642_n937# sky130_fd_pr__pfet_01v8 w=3e+06u l=300000u
X3 a_n442_n718# a_n505_n815# a_n560_n718# w_n1642_n937# sky130_fd_pr__pfet_01v8 w=3e+06u l=300000u
X4 a_n678_118# a_n741_21# a_n796_118# w_n1642_n937# sky130_fd_pr__pfet_01v8 w=3e+06u l=300000u
X5 a_856_118# a_793_21# a_738_118# w_n1642_n937# sky130_fd_pr__pfet_01v8 w=3e+06u l=300000u
X6 a_148_n718# a_85_n815# a_30_n718# w_n1642_n937# sky130_fd_pr__pfet_01v8 w=3e+06u l=300000u
X7 a_1210_n718# a_1147_n815# a_1092_n718# w_n1642_n937# sky130_fd_pr__pfet_01v8 w=3e+06u l=300000u
X8 a_n1386_118# a_n1449_21# a_n1504_118# w_n1642_n937# sky130_fd_pr__pfet_01v8 w=3e+06u l=300000u
X9 a_n560_118# a_n623_21# a_n678_118# w_n1642_n937# sky130_fd_pr__pfet_01v8 w=3e+06u l=300000u
X10 a_738_118# a_675_21# a_620_118# w_n1642_n937# sky130_fd_pr__pfet_01v8 w=3e+06u l=300000u
X11 a_1092_n718# a_1029_n815# a_974_n718# w_n1642_n937# sky130_fd_pr__pfet_01v8 w=3e+06u l=300000u
X12 a_n1268_118# a_n1331_21# a_n1386_118# w_n1642_n937# sky130_fd_pr__pfet_01v8 w=3e+06u l=300000u
X13 a_n1150_118# a_n1213_21# a_n1268_118# w_n1642_n937# sky130_fd_pr__pfet_01v8 w=3e+06u l=300000u
X14 a_1446_118# a_1383_21# a_1328_118# w_n1642_n937# sky130_fd_pr__pfet_01v8 w=3e+06u l=300000u
X15 a_n324_118# a_n387_21# a_n442_118# w_n1642_n937# sky130_fd_pr__pfet_01v8 w=3e+06u l=300000u
X16 a_1328_118# a_1265_21# a_1210_118# w_n1642_n937# sky130_fd_pr__pfet_01v8 w=3e+06u l=300000u
X17 a_n914_n718# a_n977_n815# a_n1032_n718# w_n1642_n937# sky130_fd_pr__pfet_01v8 w=3e+06u l=300000u
X18 a_n324_n718# a_n387_n815# a_n442_n718# w_n1642_n937# sky130_fd_pr__pfet_01v8 w=3e+06u l=300000u
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
