harryxni/TopMetalSe-OpenMPW6/(commit log)

2022-06-08 Initial add of pixel layout and schematic designs, includes 3x3 pixel array in caravel:
    [analog_wrapper_tb.sch, array_output.sch, biases.sch, csa.sch, csa_tb.sch, example_por.sch, example_por_tb.sch, output_tb.sch]
2022-06-08 schematic pdfs
2022-06-08 lef file for 100pixel array, reoganized xschem dir
    [analog_wrapper_tb.sch, csa_tb.sch, output_tb.sch, pixel.sch, pixelArray_tb.sch, untitled.sch, user_analog_project_wrapper.sch]
2022-06-09 power rings
2022-06-10 added power rings, FOM minimum test fix
2022-06-11 power ring, test FOM gds file
2022-06-11 proper 1.8V connection
2022-06-13 updated .gds with and .spice with 3x3 and power grid
2022-07-20 amplifier test benches
    [csa_tb.sch, nmos_cs.sch, pmos_fcs.sch]
2022-09-15 large file fix?
    [csa.sch, pixel.sch, pmos_fcs.sch]
2022-09-16 post tapeout power fixes
2023-05-25 beginning of simulation tools
    [csa.sch, nmos_amp_simple.sch, nmos_cs.sch, pixel_tb.sch, pmos_fcs.sch, untitled-1.sch]
2023-05-26 simulation setup for amp and csa/pixel
    [csa_tb.sch, nmos_cs.sch, pixel_tb.sch]
2023-06-15 added bias testbench for finding out supplied board values
    [bias_board_tb.sch, csa_tb.sch]
2023-06-28 fixed vdd issues
    [bias_board_tb.sch]
